hudaubaya/sidik/docs/puf-model/results.md

# RO-PUF key generator: Monte Carlo results (model)

Generated by `model/puf_montecarlo.py`. **Every number below is a model
output, not a hardware measurement.** Rates with zero events show the
95 % upper bound (rule of three) in parentheses.

## Raw 512-pair response (model)

| σ_process | σ_Δ (counts) | uniformity | uniqueness | reliability 25 °C | reliability −40 °C | reliability 85 °C |
|---|---|---|---|---|---|---|
| 0.5% | 116 | 50.08% ± 2.25% | 50.00% ± 2.22% | 98.05% | 90.30% | 90.26% |
| 1.0% | 229 | 49.79% ± 2.15% | 50.03% ± 2.20% | 98.99% | 95.03% | 94.75% |
| 2.0% | 454 | 49.99% ± 2.22% | 50.00% ± 2.24% | 99.50% | 97.53% | 97.43% |

## Key generation per τ (model)

Reconstructions at T ~ U(−40, 85) °C, enrollment at 25 °C, with the
32-bit key-check value (KCV) in the helper data.

| σ_process | τ (counts) | pairs passing mean [min–max] | chips failing enrollment | key BER 1 meas | key BER maj-3 | detected failure rate | silent wrong-key rate | needed re-measure | chips with ≥1 failure | worst chip failures / recon | key uniqueness | distinct IDs |
|---|---|---|---|---|---|---|---|---|---|---|---|---|
| 0.5% | 0 | 512 [512–512] | 0/100 | 5.50e-02 | 5.25e-02 | 8.43e-01 (84282) | 0 (< 3.0e-05) | 93.84% | 100/100 | 976/1000 | 50.00% | 100/100 |
| 0.5% | 16 | 458 [446–473] | 0/100 | 2.17e-02 | 2.05e-02 | 4.69e-01 (46896) | 0 (< 3.0e-05) | 54.46% | 100/100 | 685/1000 | 50.02% | 100/100 |
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
| 2.0% | 32 | −40 + 85 °C | 458 [440–473] | 0/100 | 0 (< 4.6e-08) | 0 (< 1.4e-07) | 0 (< 3.0e-05) | 0 (< 3.0e-05) | 0/100 | 0/1000 |
| 2.0% | 64 | 25 °C | 456 [435–473] | 0/100 | 1.49e-04 | 1.33e-04 | 6.20e-04 (62) | 0 (< 3.0e-05) | 2/100 | 36/1000 |
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
