hudaubaya/sidik/(commit log)

2026-10-03 Add RO-PUF key generator model and Monte Carlo study
    model/ro_puf.py models a 1024-RO chip (process spread, per-measurement
    jitter, linear temperature drift with per-RO tempco spread), disjoint
    pairs (2i, 2i+1) measured by racing counters to 2^14, enrollment (mean of
    16, mask |mean| >= tau, first 216 pairs, 3 x 72-bit blocks with Hsiao
    (72,64) syndromes as helper data), reconstruction (majority of 3, 1-bit
    correction, re-measure detected blocks up to 3 times), and
    K = SHA-256(bits || "SIDIK-K") with HMAC-based ID and auth tag.
    model/puf_montecarlo.py sweeps sigma_process x tau over 100 chips x 1000
    reconstructions at T ~ U(-40, 85) C and writes docs/puf-model/ (tables,
    JSON, figures). docs/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
2026-10-03 Add 32-bit key-check value to the PUF helper data
    Helper data now carries KCV = first 32 bits of HMAC-SHA256(K,
    "SIDIK-CHK"). During reconstruction, a candidate key whose blocks all
    decode but whose KCV does not match (a SECDED miscorrection) has all
    three blocks re-measured within the same 3-round budget; a KCV still
    wrong at the end is a detected failure. kcv_bits=0 disables it and
    reproduces the previous results exactly.
    The Monte Carlo now runs both variants on the same noise streams. With
    the KCV no silent wrong key occurs in any configuration (< 3e-5 each);
    those cases become detected failures, and re-measurement recovers only
    5-19 % of them because the temperature is unchanged. Repor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
2026-10-03 Add two-temperature enrollment to the PUF model
    KeyGenParams.enroll_temps_c sets the enrollment temperatures (default
    25 C only, which reproduces the previous results). With several
    temperatures, a pair passes the mask only when its mean delta has the
    same sign at every temperature and |mean delta| >= tau at each; the key
    bit is the sign at the first temperature.
    The Monte Carlo adds 25 + 85 C and -40 + 85 C enrollment (KCV on) on the
    same chips and reconstruction noise. Corner enrollment removes all
    observed failures for tau >= 16; 25 + 85 C roughly halves them. The
    report notes that the corner result is optimistic by construction (the
    model's tempco is linear) and needs a temperature cham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
2026-10-03 Add RO-PUF measurement RTL in rtl/ropuf
    1024 ring oscillators (NAND + 4 inverters each) in disjoint pairs
    (2i, 2i+1). A measurement enables only the selected pair and races one
    counter per RO: the winner stops at exactly 2^14 in its own clock domain,
    the loser stops when that reaches it through a 2-flop synchronizer. A
    control FSM sequences clear / arm / run / stop with a timeout; an
    Avalon-MM slave exposes ID, PARAMS, CTRL, PAIR, COUNT_A, COUNT_B, DELTA
    and TIMEOUT.
    Each RO stage is a separate preserved ro_stage instance: with keep
    attributes on the nets only, yosys reduced every RO to one inverter.
    synth_check.py (make synth-check, now in CI with yosys installed) fails
    if any stage is rem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
    [ro_cell.v, ropuf_avmm.v, ropuf_core.v, synth_check.py]
2026-10-03 Add rtl/secded72.v and switch the model to extended Hamming
    rtl/secded72.v: combinational extended Hamming (72,64) SECDED for the
    PUF's syndrome sketch. Column j of H is {1, j[6:0]}: syndrome bits 6..0
    give the error position (the Hamming principle ECC_test1 uses) and bit
    7 is the overall parity. Outputs the syndrome, the corrected word, and
    single-error / uncorrectable flags.
    model/secded.py used a Hsiao (72,64) code, so an extended Hamming RTL
    could not be identical to it. The model now uses the same extended
    Hamming code. The Monte Carlo is rerun and docs/puf-model.md updated:
    without the KCV, extended Hamming gives 20-58 % more silent wrong keys
    than Hsiao; with the KCV the failure rate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
    [mutants.py, secded72.v]
2026-10-03 Add rtl/ro_cell.v, ro_array.v, puf_meas.v; build rtl/ropuf from them
    rtl/ro_cell.v: NAND-enable ring of LUT stages. CYCLONEV path uses an
    lcell primitive per stage; the generic path keeps the preserved ro_stage
    instances; the SIM path is a behavioural oscillator whose half-period
    comes from HALF_PERIOD_NS or, when that is 0, from +RO_SEED and the
    index (mirrored exactly by tb/common/ro_sim.py).
    rtl/ro_array.v: 1024 ROs; only the two ROs of the selected pair are
    enabled. Per-RO enables and outputs are exposed for tests.
    rtl/puf_meas.v: two counters race to 2^14 RO cycles behind a ripple
    prescaler (one toggle flip-flop per stage at f_RO; the counter runs at
    f_RO/2), stop through a 2-flop syn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
    [lcell_stub.v, puf_meas.v, ro_array.v, ro_cell.v, ro_sim.py, ropuf_core.v]
2026-10-03 Add rtl/fuzzy_ext.v: PUF enrollment/reconstruction FSM matching the model
    rtl/fuzzy_ext.v implements the key generator of model/ro_puf.py in
    hardware, with rtl/secded72.v as the secure sketch.
    - Enrollment, one phase per temperature (enroll_first / enroll_last):
    - N_ENROLL races per pair; pass = |sum| >= N_ENROLL * tau.
    - The sign must agree across phases.
    - The first 216 passing pairs are selected.
    - Helper data out: 512-bit mask + 3 x 8-bit syndromes.
    - Reconstruction:
    - Majority of 3 races per selected pair.
    - SECDED decode per block; a detected block is re-measured.
    - The key check (KCV) is done by the consumer via key_valid /
    key_ack / key_good; a mismatch re-measures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
2026-10-04 Add rtl/sidik_crypto.v: K derivation and HMAC-SHA256 on the Shaman core
    rtl/sidik_crypto.v wraps the unmodified Shaman core (file hash unchanged).
    Operations:
    - OP_DERIVE: K = SHA-256(216 key bits, MSB first || "SIDIK-K"), 1 block.
    K stays in k_q.
    - OP_HMAC: HMAC-SHA256(K, 32-byte challenge).
    - OP_ID: HMAC(K, "SIDIK-ID").
    - OP_KCV: HMAC(K, "SIDIK-CHK"); the KCV is result[255:224].
    Each HMAC is an inner and an outer hash of 2 blocks each. All padding is
    constant. `clear` erases K and the result.
    Shaman protocol, byte-serial mode:
    - Core reset, then start, for every hash.
    - Strobe high 1 cycle, low 1 cycle.
    - No byte right after the 64th; then GAP cycles, and wait for busy (and
    resultRead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
    [mutants.py, sidik_crypto.v, tb.v, test_sidik_crypto.py]
2026-10-04 Update docs/status.md through PR #12
    - Header, summary and the README link now refer to 2026-10-04, with main
    at 5267c48.
    - Verification table: rows for fuzzy_ext, sidik_crypto and sidik_avmm,
    each with what is proven in simulation and what is not.
    - PR history: #9 to #12, with the main CI durations.
    - RTL table: the three new modules and the SIM-only select tree in
    ro_array.
    - Risks: read-path proof is behavioural only; zeroize is an OR used as an
    async reset; simulation parameters differ from release; CI time.
    - Next steps: build sidik_avmm on the board, a structural read-path check,
    two-temperature enrollment in the register API.
    - Appendix: current test, mutant and synth-check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
